michaelkamprath/rp2040-rust-robot/hardware/chassis-drill-template.pdf

## Front

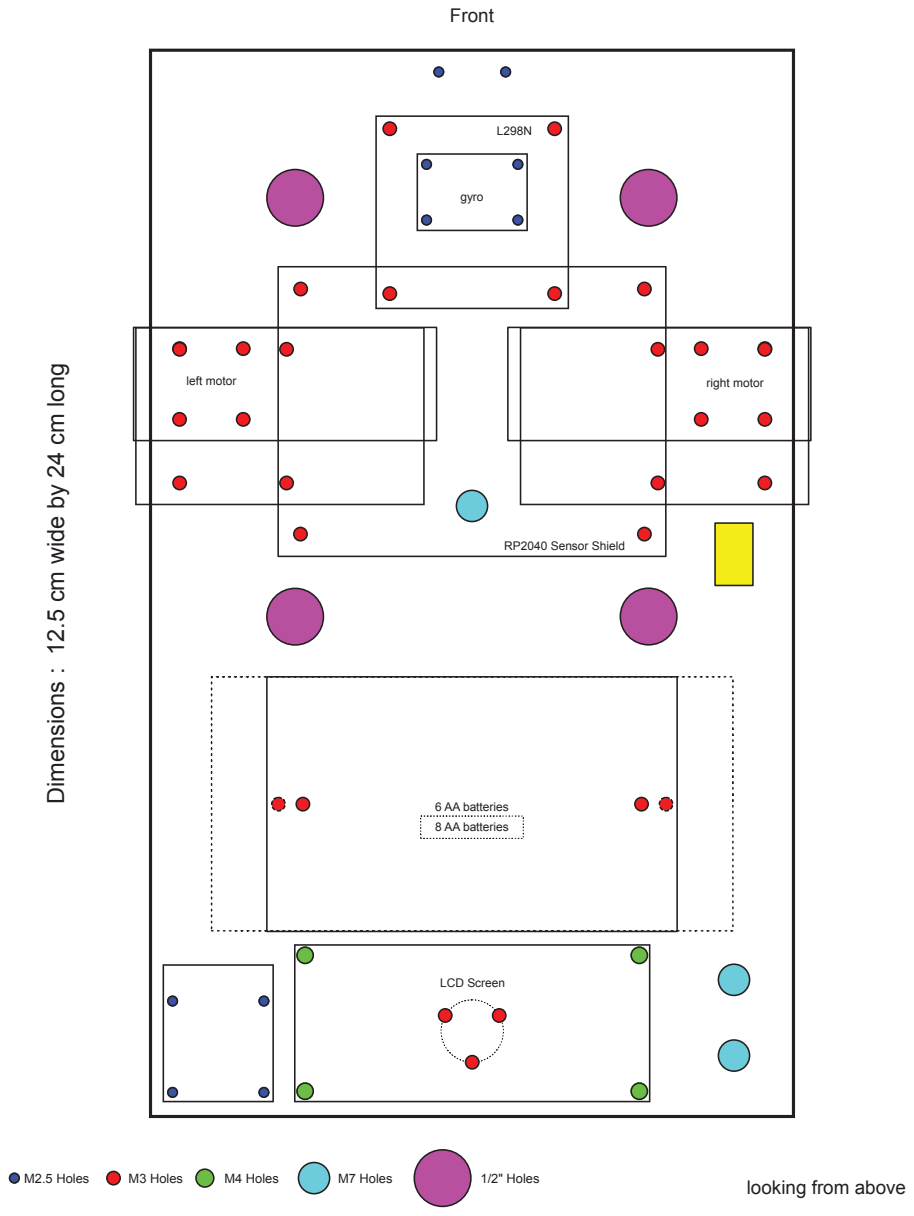
[picture p1: page 1]
M2.5 Holes; M3 Holes; M4 Holes; M7 Holes; 1/2" Holes; gyro; LCD Screen; left motor; right motor; RP2040 Sensor Shield; 6 AA batteries; 8 AA batteries

Dimensions : 12.5 cm wide by 24 cm long

looking from above
