michaelkamprath/rp2040-rust-robot/hardware/rp-pico-sensor-shield/rp-pico-sensor-shield.kicad_pcb

## KiCad design hardware/rp-pico-sensor-shield/rp-pico-sensor-shield.kicad_pcb (2024-11-28)

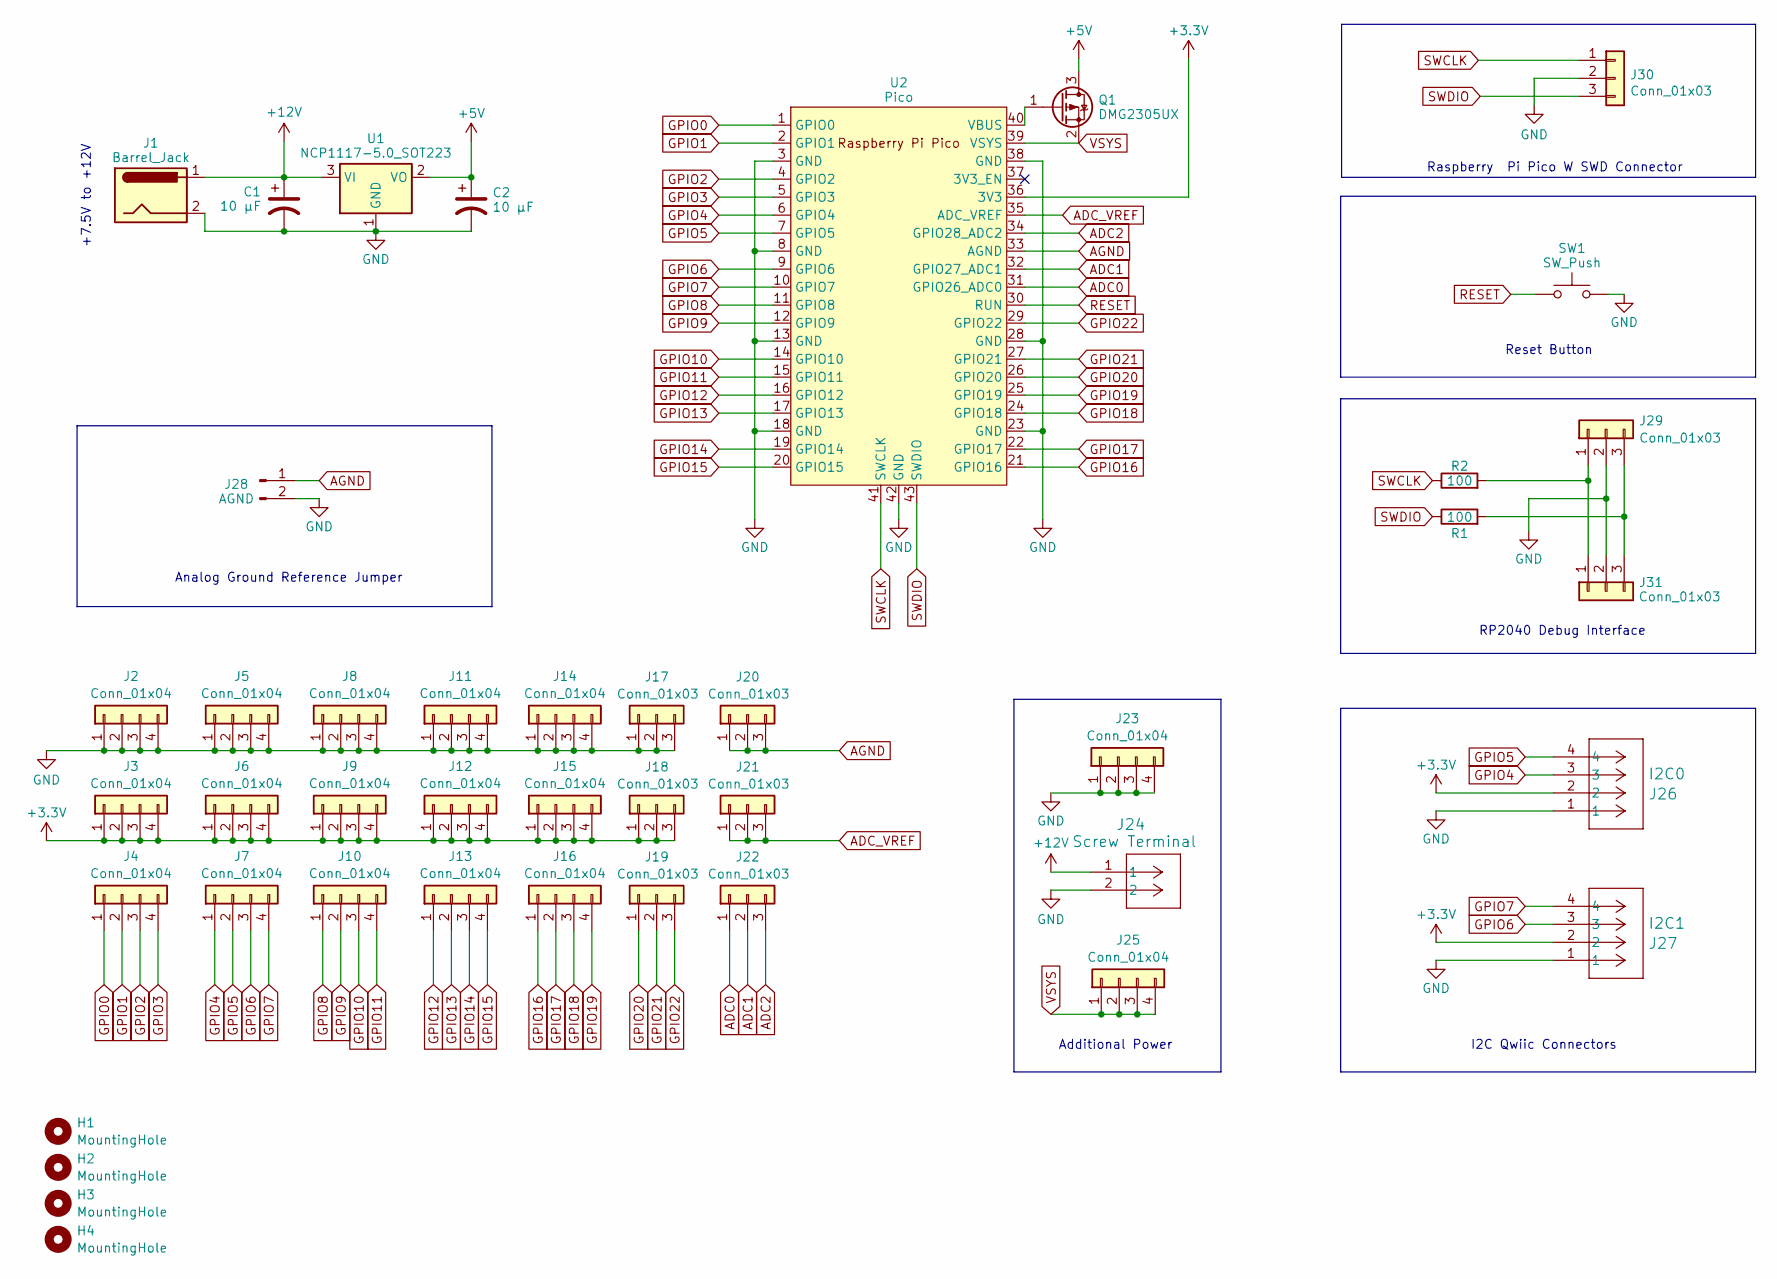
[picture p2: schematic rp-pico-sensor-shield.kicad_sch]

Parts:
C1, C2: 10 µF; C_1206_3216Metric_Pad1.33x1.80mm_HandSolder
H1, H2, H3, H4: MountingHole; MountingHole_3.2mm_M3_ISO7380_Pad
J1: Barrel_Jack; BarrelJack_Horizontal
J2, J3, J4, J5, J6, J7, J8, J9, J10, J11, J12, J13, J14, J15, J16, J23, J25: Conn_01x04; PinHeader_1x04_P2.54mm_Vertical
J17, J18, J19, J20, J21, J22: Conn_01x03; PinHeader_1x03_P2.54mm_Vertical
J24: Screw Terminal; CONN2_1760510000_WED
J26: I2C0; CONN_SM04B-SRSS-TB_JST
J27: I2C1; CONN_SM04B-SRSS-TB_JST
J28: AGND; PinHeader_1x02_P2.54mm_Vertical
J29: Conn_01x03; JST_SH_BM03B-SRSS-TB_1x03-1MP_P1.00mm_Vertical
J30: Conn_01x03; PinHeader_1x03_P1.00mm_Vertical
J31: Conn_01x03; PinHeader_1x03_P2.54mm_Horizontal
Q1: DMG2305UX; SOT-23
R1, R2: 100; R_1206_3216Metric_Pad1.30x1.75mm_HandSolder
SW1: SW_Push; SW_PUSH_6mm
U1: NCP1117-5.0_SOT223; SOT-223-3_TabPin2
U2: Pico; RPi_Pico_SMD_TH

Connections:
+3.3V: J3.1, J3.2, J3.3, J3.4, J6.1, J6.2, J6.3, J6.4, J9.1, J9.2, J9.3, J9.4, J12.1, J12.2, J12.3, J12.4, J15.1, J15.2, J15.3, J15.4, J18.1, J18.2, J18.3, J26.2, J27.2, U2.36 (3V3)
+5V: C2.1, Q1.3 (D), U1.2 (VO)
+12V: C1.1, J1.1, J24.1, U1.3 (VI)
ADC0: J22.1, U2.31 (GPIO26_ADC0)
ADC1: J22.2, U2.32 (GPIO27_ADC1)
ADC2: J22.3, U2.34 (GPIO28_ADC2)
ADC_VREF: J21.1, J21.2, J21.3, U2.35 (ADC_VREF)
AGND: J20.1, J20.2, J20.3, J28.1, U2.33 (AGND)
GND: C1.2, C2.2, J1.2, J2.1, J2.2, J2.3, J2.4, J5.1, J5.2, J5.3, J5.4, J8.1, J8.2, J8.3, J8.4, J11.1, J11.2, J11.3, J11.4, J14.1, J14.2, J14.3, J14.4, J17.1, J17.2, J17.3, J23.1, J23.2, J23.3, J23.4, J24.2, J26.1, J27.1, J28.2, J29.2, J30.2, J31.2, SW1.2, U1.1 (GND), U2.3 (GND), U2.8 (GND), U2.13 (GND), U2.18 (GND), U2.23 (GND), U2.28 (GND), U2.38 (GND), U2.42 (GND)
GPIO0: J4.1, U2.1 (GPIO0)
GPIO1: J4.2, U2.2 (GPIO1)
GPIO2: J4.3, U2.4 (GPIO2)
GPIO3: J4.4, U2.5 (GPIO3)
GPIO4: J7.1, J26.3, U2.6 (GPIO4)
GPIO5: J7.2, J26.4, U2.7 (GPIO5)
GPIO6: J7.3, J27.3, U2.9 (GPIO6)
GPIO7: J7.4, J27.4, U2.10 (GPIO7)
GPIO8: J10.1, U2.11 (GPIO8)
GPIO9: J10.2, U2.12 (GPIO9)
GPIO10: J10.3, U2.14 (GPIO10)
GPIO11: J10.4, U2.15 (GPIO11)
GPIO12: J13.1, U2.16 (GPIO12)
GPIO13: J13.2, U2.17 (GPIO13)
GPIO14: J13.3, U2.19 (GPIO14)
GPIO15: J13.4, U2.20 (GPIO15)
GPIO16: J16.1, U2.21 (GPIO16)
GPIO17: J16.2, U2.22 (GPIO17)
GPIO18: J16.3, U2.24 (GPIO18)
GPIO19: J16.4, U2.25 (GPIO19)
GPIO20: J19.1, U2.26 (GPIO20)
GPIO21: J19.2, U2.27 (GPIO21)
GPIO22: J19.3, U2.29 (GPIO22)
unnamed: J29.1, J31.1, R2.2
unnamed: J29.3, J31.3, R1.2
unnamed: Q1.1 (G), U2.40 (VBUS)
RESET: SW1.1, U2.30 (RUN)
SWCLK: J30.1, R2.1, U2.41 (SWCLK)
SWDIO: J30.3, R1.1, U2.43 (SWDIO)
VSYS: J25.1, J25.2, J25.3, J25.4, Q1.2 (S), U2.39 (VSYS)

Notes on the sheet:
I2C Qwiic Connectors
Reset Button
Additional Power
+7.5V to +12V
RP2040 Debug Interface
Analog Ground Reference Jumper
Raspberry Pi Pico W SWD Connector

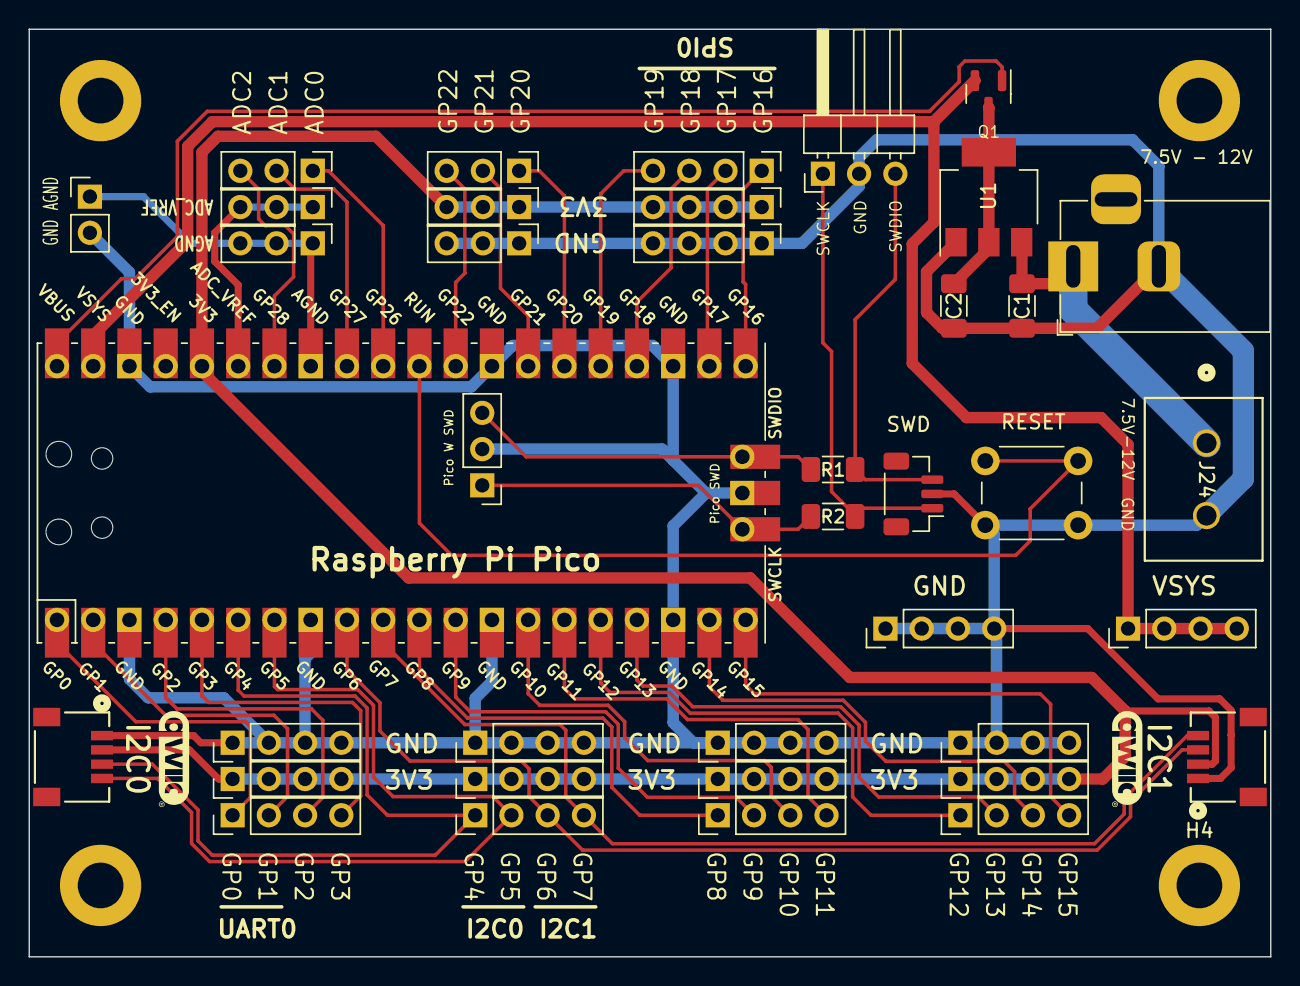
[picture p3: board rp-pico-sensor-shield.kicad_pcb from above]

Board: 2 copper layers, 87.0 x 65.0 mm, 43 parts (0 on the bottom side), 39 nets.
