michaelkamprath/rp2040-rust-robot/src/robot/config.rs

use alloc::string::{String, ToString};
use defmt::{debug, info, trace, warn};
use ini_core as ini;

const WHEEL_DIAMETER: f32 = 67.0; // mm
const WHEEL_CIRCUMFERENCE: f32 = WHEEL_DIAMETER * core::f32::consts::PI;
const WHEEL_TICKS_PER_MM: f32 = 3.0;

const STRAIGHT_LEFT_MOTOR_POWER: u8 = 100;
const STRAIGHT_RIGHT_MOTOR_POWER: u8 = 100;
const STRAIGHT_PID_P: f32 = 0.5;
const STRAIGHT_PID_I: f32 = 0.0;
const STRAIGHT_PID_D: f32 = 0.0;

const DEFAULT_IDLE_MESSAGE: &str = "Robot Idle";

pub struct Config {
    // straight configuration
    /// Motor power for left straight movement in integer percent (max 100)
    pub straight_left_power: u8,
    /// Motor power for right straight movement in integer percent (max 100)
    pub straight_right_power: u8,
    pub straight_pid_p: f32,
    pub straight_pid_i: f32,
    pub straight_pid_d: f32,
    // turn configuration
    /// Motor power for left turn in integer percent (max 100)
    pub turn_left_left_power: u8,
    /// Motor power for right turn in integer percent (max 100)
    pub turn_left_right_power: u8,
    /// Motor power for left turn in integer percent (max 100)
    pub turn_right_left_power: u8,
    /// Motor power for right turn in integer percent (max 100)
    pub turn_right_right_power: u8,
    pub turn_left_stop_angle_delta: i32,
    pub turn_right_stop_angle_delta: i32,
    // general configuration
    pub wheel_ticks_per_mm: f32,
    pub idle_message: String,
    // gyro offsets
    pub gyro_offset_x: i16,
    pub gyro_offset_y: i16,
    pub gyro_offset_z: i16,
}

impl Config {
    pub fn new() -> Self {
        Self {
            straight_left_power: STRAIGHT_LEFT_MOTOR_POWER,
            straight_right_power: STRAIGHT_RIGHT_MOTOR_POWER,
            straight_pid_p: STRAIGHT_PID_P,
            straight_pid_i: STRAIGHT_PID_I,
            straight_pid_d: STRAIGHT_PID_D,
            turn_left_left_power: 100,
            turn_left_right_power: 100,
            turn_right_left_power: 100,
            turn_right_right_power: 100,
            turn_left_stop_angle_delta: 0,
            turn_right_stop_angle_delta: 0,
            wheel_ticks_per_mm: WHEEL_TICKS_PER_MM,
            idle_message: String::from(DEFAULT_IDLE_MESSAGE),
            gyro_offset_x: 0,
            gyro_offset_y: 0,
            gyro_offset_z: 0,
        }
    }

    pub fn set_config_values(&mut self, config_str: &str) {
        let config = ini::Parser::new(config_str);
        for item in config {
            match item {
                ini::Item::Section(section) => {
                    debug!("Config section: {}", section);
                }
                ini::Item::Property(key, value) => {
                    trace!("Config key: {}, value: {}", key, value);
                    match key.trim() {
                        "straight_left_power" => {
                            if value.is_some() {
                                if let Ok(power) = value.unwrap().trim().parse::<u8>() {
                                    self.straight_left_power = power;
                                    if self.straight_left_power > 100 {
                                        self.straight_left_power = 100;
                                    }
                                    trace!("CONFIG: left motor power = {}", power);
                                }
                            }
                        }
                        "straight_right_power" => {
                            if value.is_some() {
                                if let Ok(power) = value.unwrap().trim().parse::<u8>() {
                                    self.straight_right_power = power;
                                    if self.straight_right_power > 100 {
                                        self.straight_right_power = 100;
                                    }
                                    trace!("CONFIG: right motor power = {}", power);
                                }
                            }
                        }
                        "straight_pid_p" => {
                            if value.is_some() {
                                if let Ok(pid_p) = value.unwrap().trim().parse::<f32>() {
                                    self.straight_pid_p = pid_p;
                                    trace!(
                                        "CONFIG: straight PID controller parameter P = {}",
                                        pid_p
                                    );
                                }
                            }
                        }
                        "straight_pid_i" => {
                            if value.is_some() {
                                if let Ok(pid_i) = value.unwrap().trim().parse::<f32>() {
                                    self.straight_pid_i = pid_i;
                                    trace!(
                                        "CONFIG: straight PID controller parameter P = {}",
                                        pid_i
                                    );
                                }
                            }
                        }
                        "straight_pid_d" => {
                            if value.is_some() {
                                if let Ok(pid_d) = value.unwrap().trim().parse::<f32>() {
                                    self.straight_pid_d = pid_d;
                                    trace!(
                                        "CONFIG: straight PID controller parameter P = {}",
                                        pid_d
                                    );
                                }
                            }
                        }
                        "turn_left_left_power" => {
                            if value.is_some() {
                                if let Ok(power) = value.unwrap().trim().parse::<u8>() {
                                    self.turn_left_left_power = power;
                                    if self.turn_left_left_power > 100 {
                                        self.turn_left_left_power = 100;
                                    }
                                    trace!("CONFIG: left motor power for left turn = {}", power);
                                }
                            }
                        }
                        "turn_left_right_power" => {
                            if value.is_some() {
                                if let Ok(power) = value.unwrap().trim().parse::<u8>() {
                                    self.turn_left_right_power = power;
                                    if self.turn_left_right_power > 100 {
                                        self.turn_left_right_power = 100;
                                    }
                                    trace!("CONFIG: right motor power for left turn = {}", power);
                                }
                            }
                        }
                        "turn_right_left_power" => {
                            if value.is_some() {
                                if let Ok(power) = value.unwrap().trim().parse::<u8>() {
                                    self.turn_right_left_power = power;
                                    if self.turn_right_left_power > 100 {
                                        self.turn_right_left_power = 100;
                                    }
                                    trace!("CONFIG: left motor power for right turn = {}", power);
                                }
                            }
                        }
                        "turn_right_right_power" => {
                            if value.is_some() {
                                if let Ok(power) = value.unwrap().trim().parse::<u8>() {
                                    self.turn_right_right_power = power;
                                    if self.turn_right_right_power > 100 {
                                        self.turn_right_right_power = 100;
                                    }
                                    trace!("CONFIG: right motor power for right turn = {}", power);
                                }
                            }
                        }
                        "turn_left_stop_angle_delta" => {
                            if value.is_some() {
                                if let Ok(delta) = value.unwrap().trim().parse::<i32>() {
                                    self.turn_left_stop_angle_delta = delta;
                                    info!("CONFIG: stop angle delta for left turn = {}", delta);
                                }
                            }
                        }
                        "turn_right_stop_angle_delta" => {
                            if value.is_some() {
                                if let Ok(delta) = value.unwrap().trim().parse::<i32>() {
                                    self.turn_right_stop_angle_delta = delta;
                                    trace!("CONFIG: stop angle delta for right turn = {}", delta);
                                }
                            }
                        }
                        "wheel_ticks_per_mm" => {
                            if value.is_some() {
                                if let Ok(ticks_per_mm) = value.unwrap().trim().parse::<f32>() {
                                    self.wheel_ticks_per_mm = ticks_per_mm;
                                    trace!("CONFIG: wheel ticks per mm = {}", ticks_per_mm);
                                }
                            }
                        }
                        "idle_message" => {
                            if value.is_some() {
                                self.idle_message = value.unwrap().trim().to_string();
                                trace!("CONFIG: idle message = {}", self.idle_message.as_str());
                            }
                        }
                        "gyro_offset_x" => {
                            if value.is_some() {
                                if let Ok(offset) = value.unwrap().trim().parse::<i16>() {
                                    self.gyro_offset_x = offset;
                                    trace!("CONFIG: gyro offset x = {}", offset);
                                }
                            }
                        }
                        "gyro_offset_y" => {
                            if value.is_some() {
                                if let Ok(offset) = value.unwrap().trim().parse::<i16>() {
                                    self.gyro_offset_y = offset;
                                    trace!("CONFIG: gyro offset y = {}", offset);
                                }
                            }
                        }
                        "gyro_offset_z" => {
                            if value.is_some() {
                                if let Ok(offset) = value.unwrap().trim().parse::<i16>() {
                                    self.gyro_offset_z = offset;
                                    trace!("CONFIG: gyro offset z = {}", offset);
                                }
                            }
                        }
                        _ => {
                            warn!("CONFIG: unknown key: {}", key);
                        }
                    }
                }
                _ => {}
            }
        }
    }
}

impl defmt::Format for Config {
    fn format(&self, f: defmt::Formatter<'_>) {
        defmt::write!(
            f,
            "Config {{\n  straight_left_power = {},\n  straight_right_power = {},\n  straight_pid_p = {},\n  straight_pid_i = {},\n  straight_pid_d = {},\n  turn_left_left_power = {},\n  turn_left_right_power = {},\n  turn_right_left_power = {},\n  turn_right_right_power = {},\n  turn_left_stop_angle_delta = {},\n  turn_right_stop_angle_delta = {},\n  wheel_ticks_per_mm = {},\n  idle_message = {}\n  gyro_offset_x = {}\n  gyro_offset_y = {}\n  gyro_offset_z = {}\n}}",
            self.straight_left_power, self.straight_right_power, self.straight_pid_p, self.straight_pid_i, self.straight_pid_d, self.turn_left_left_power, self.turn_left_right_power, self.turn_right_left_power, self.turn_right_right_power, self.turn_left_stop_angle_delta, self.turn_right_stop_angle_delta, self.wheel_ticks_per_mm, self.idle_message.as_str(), self.gyro_offset_x, self.gyro_offset_y, self.gyro_offset_z
        );
    }
}

impl core::fmt::Display for Config {
    fn fmt(&self, f: &mut core::fmt::Formatter<'_>) -> core::fmt::Result {
        write!(
            f,
            "Config {{\n  straight_left_power = {},\n  straight_right_power = {},\n  straight_pid_p = {},\n  straight_pid_i = {},\n  straight_pid_d = {},\n  turn_left_left_power = {},\n  turn_left_right_power = {},\n  turn_right_left_power = {},\n  turn_right_right_power = {},\n  turn_left_stop_angle_delta = {},\n  turn_right_stop_angle_delta = {},\n  wheel_ticks_per_mm = {},\n  idle_message = {}\n  gyro_offset_x = {}\n  gyro_offset_y = {}\n  gyro_offset_z = {}\n}}",
            self.straight_left_power, self.straight_right_power, self.straight_pid_p, self.straight_pid_i, self.straight_pid_d, self.turn_left_left_power, self.turn_left_right_power, self.turn_right_left_power, self.turn_right_right_power, self.turn_left_stop_angle_delta, self.turn_right_stop_angle_delta, self.wheel_ticks_per_mm, self.idle_message.as_str(), self.gyro_offset_x, self.gyro_offset_y, self.gyro_offset_z
        )
    }
}
