michaelkamprath/rp2040-rust-robot/config/config.ini

[STRAIGHT_MOTION]
straight_left_power = 100
straight_right_power = 100
straight_pid_p = 0.4
straight_pid_i = 0.0002
straight_pid_d = 0.0001

[TURN_MOTION]
turn_left_left_power = 70
turn_left_right_power = 70
turn_left_stop_angle_delta = -1
turn_right_left_power = 70
turn_right_right_power = 70
turn_right_stop_angle_delta = -1

[GENERAL]
wheel_ticks_per_mm = 2.971378091872792
idle_message = Kamprath Bot
gyro_offset_x = 111
gyro_offset_y = 22
gyro_offset_z = 3
