michaelkamprath/rp2040-rust-robot/(commit log)

2023-12-26 added raspberry pi pico sensor shield design
    [rp-pico-sensor-shield.kicad_pcb, rp-pico-sensor-shield.kicad_sch]
2023-12-28 added i2c init
2023-12-29 added pid controller class
    also updated schematic of sensor board to have two IC2 Qwiic connectors
    [rp-pico-sensor-shield.kicad_sch]
2023-12-30 added wheel encoder interupt support
2023-12-30 added millis utility
2023-12-31 addedsupport for mpu6050 gyro
2024-01-06 finalized pin wiring
    [rp-pico-sensor-shield.kicad_pcb, rp-pico-sensor-shield.kicad_sch]
2024-01-06 wip update to rp2040 sensor shield
    [rp-pico-sensor-shield.kicad_pcb, rp-pico-sensor-shield.kicad_sch]
2024-01-06 finalized sensor shield design
    [rp-pico-sensor-shield.kicad_pcb]
2024-01-07 added better button debouncing
2024-01-07 added qwiic logo
    [rp-pico-sensor-shield.kicad_pcb]
2024-01-13 refactored to have driver object
2024-01-14 added basic pid controller to straight movement
2024-02-11 updated sensor shield layout
    [rp-pico-sensor-shield.kicad_pcb, rp-pico-sensor-shield.kicad_sch]
2024-02-12 tweaked trace size
    [rp-pico-sensor-shield.kicad_pcb]
2024-02-18 added ability to traverse a segment in reverse
    [driver.rs, point.rs, robot.rs]
2024-02-24 dtill template for chassis
2024-02-25 kicad v8 upgrade
    [rp-pico-sensor-shield.kicad_pcb, rp-pico-sensor-shield.kicad_sch]
2024-05-08 added gyro status display
2024-09-25 fixed inline options and other tweaks
    [main.rs, robot.rs]
2024-09-30 Upgrade to embedded-hal 1.0 (#2)
    * test build
    * added init check to heading usage
    * further testing on spu and i2c bus
    * tried critical section devices
    * removed inlining config
    * changed pin type
    * switched LCD interface to i2c-character-display
    * adjusted logging
    * pr fixes
    [config.rs, debouncer.rs, driver.rs, file_storage.rs, logger.rs, main.rs, motor_controller.rs, robot.rs]
2024-09-30 changed pin type
2024-10-25 updated millis count to u64
2024-10-26 improved millis support
2024-11-28 serperated I2C busses for display and gyro
    [rp-pico-sensor-shield.kicad_pcb, rp-pico-sensor-shield.kicad_sch]
2024-11-29 Move heading calculation to core 1 (#3)
    In order to improve the consistency and reliability of heading calculations, move the work to maintain the heading to the second core on the RP2040, core 1. This required dedicating a I2C bus to each core, and thus affined IC20 to core 1 and I2C1 to core 0. This was solely done for wire length and placement reasons.
    There is no longer an option to calibrate the gyro. Instead, the gyro will always be calibrated on start up if there are no offsets set in the config file (that is, all values are 0), otherwise the offsets in the config file are used. gpio16 now indicates whether the gyro is fully initialized and calibrated, being set HIGH when the start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
    [driver.rs, file_storage.rs, heading_core1.rs, logger.rs, main.rs]
2024-11-29 added means to inspect gyro offsets
2024-11-30 updated to use built in LED as gyro readiness indicator
2024-12-07 made the status LED blink while calibrating gyro
2024-12-08 corrected bug in how heading was used when driving straight
    [robot.rs]
