michaelkamprath/rp2040-rust-robot/(notices)

Notices in the files:
hardware/rp-pico-sensor-shield/rp-pico-sensor-shield.kicad_pcb:
©2024 by Michael Kamprath
